podonoghue/usbdm-kinetis/README.md

# usbdm-kinetis

USBDM BDM based on Kinetis device

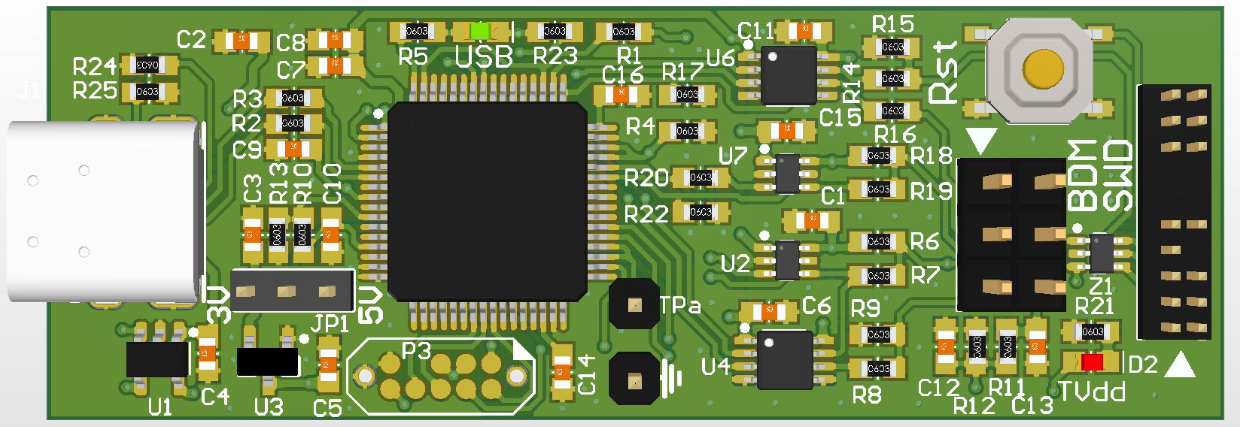
[picture p1: Hardware/USBDM_Kinetis_MK22F/USBDM_Kinetis_MK22F.png]
An image Board Image
