podonoghue/usbdm-kinetis/Hardware/README.md

# USBDM Kinetis (PCB Designs)  
PCB designs for Kinetis based USBDM.  
These are Altium designer projects.  

# USBDM_Kinetis_MK22F_V3.3 (MK22F Version)  
Supports initial bootloader, higher speed communication.  
Refer to the PDFs in the Project Outputs directory 
<a href="https://raw.githubusercontent.com/podonoghue/usbdm-kinetis/master/Hardware/USBDM_Kinetis_MK22F/USBDM_Kinetis_MK22F.PDF">PDF Documentation</img></a>

An image Board Image
