podonoghue/usbdm-kinetis/Firmware/ReadMe.md

# usbdm-kinetis

USBDM BDM based on Kinetis device

This is the firmware for the BDM.  
It required Eclipse with USBDM plugins and ARM toolchain.
