podonoghue/usbdm-kinetis/Hardware/USBDM_Kinetis_MK22F/USBDM_Kinetis.PcbDoc.htm

Reporting Options

# File in Previous Format

Date | : | 11-Jan-22
Time | : | 10:05:31 PM
Filename | : | Z:\Documents\Development\usbdm-kinetis\Hardware\USBDM_Kinetis_MK22F\USBDM_Kinetis.PcbDoc

Version | Warning

This file was generated by an earlier version of the software
