podonoghue/usbdm-kinetis/Hardware/Id.xlsx

 |  | Ratio | R1 | R2 | Ratio | R1 | R2 | R1 | R2
 | 0 | 0.00 | 10 | 0.00 | 0.00 | 10.00 | 0.00 | 10K | 0R | 0.00 | 10K/0R | 0.0 | 17.08
 | 0.06666666667 | 0.07 | 10 | 0.71 | 0.07 | 10.00 | 0.71 | 10K | 715R | 17.08 | 10K/715R | 1.0 | 17.08
 | 0.1333333333 | 0.13 | 10 | 1.54 | 0.13 | 10.00 | 1.54 | 10K | 1.54K | 34.16 | 10K/1.54K | 2.0 | 16.87
 | 0.2 | 0.20 | 10 | 2.50 | 0.20 | 10.00 | 2.49 | 10K | 2.49K | 51.04 | 10K/2.49K | 3.0 | 17.42
 | 0.2666666667 | 0.27 | 10 | 3.64 | 0.27 | 10.00 | 3.65 | 10K | 3.65K | 68.45 | 10K/3.65K | 4.0 | 16.77
 | 0.3333333333 | 0.33 | 10 | 5.00 | 0.33 | 10.00 | 4.99 | 10K | 4.99K | 85.22 | 10K/4.99K | 5.0 | 17.03
 | 0.4 | 0.40 | 10 | 6.67 | 0.40 | 10.00 | 6.65 | 10K | 6.65K | 102.25 | 10K/6.65K | 6.0 | 16.56
0 | 0.4666666667 | 0.47 | 10 | 8.75 | 0.46 | 10.00 | 8.66 | 10K | 8.66K | 118.81 | 10K/8.66K | 7.0 | 18.38
0.6666666667 | 0.5333333333 | 0.53 | 8.75 | 10.00 | 0.54 | 8.66 | 10.00 | 8.66K | 10K | 137.19 | 8.66K/10K | 8.0 | 16.56
1.428571429 | 0.6 | 0.60 | 6.67 | 10.00 | 0.60 | 6.65 | 10.00 | 6.65K | 10K | 153.75 | 6.65K/10K | 9.0 | 17.03
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
