podonoghue/usbdm-kinetis/Hardware/USBDM_Kinetis_MK22F/USBDM_Kinetis_MK22F_V3_2.png

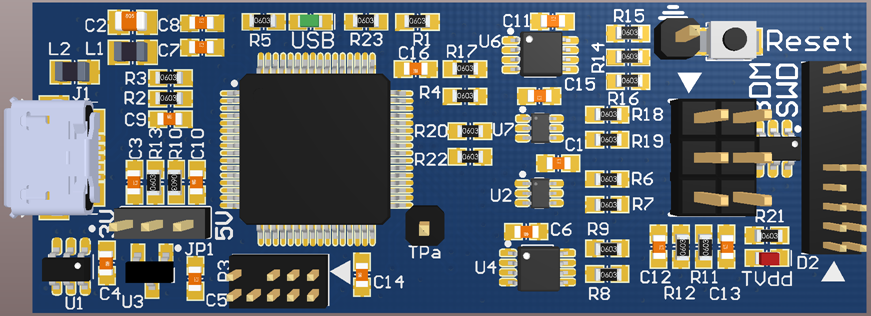
Hardware/USBDM_Kinetis_MK22F/USBDM_Kinetis_MK22F_V3_2.png
