podonoghue/usbdm-kinetis/Hardware/USBDM_Kinetis_MK22F/USBDM_Kinetis_MK22F.PDF

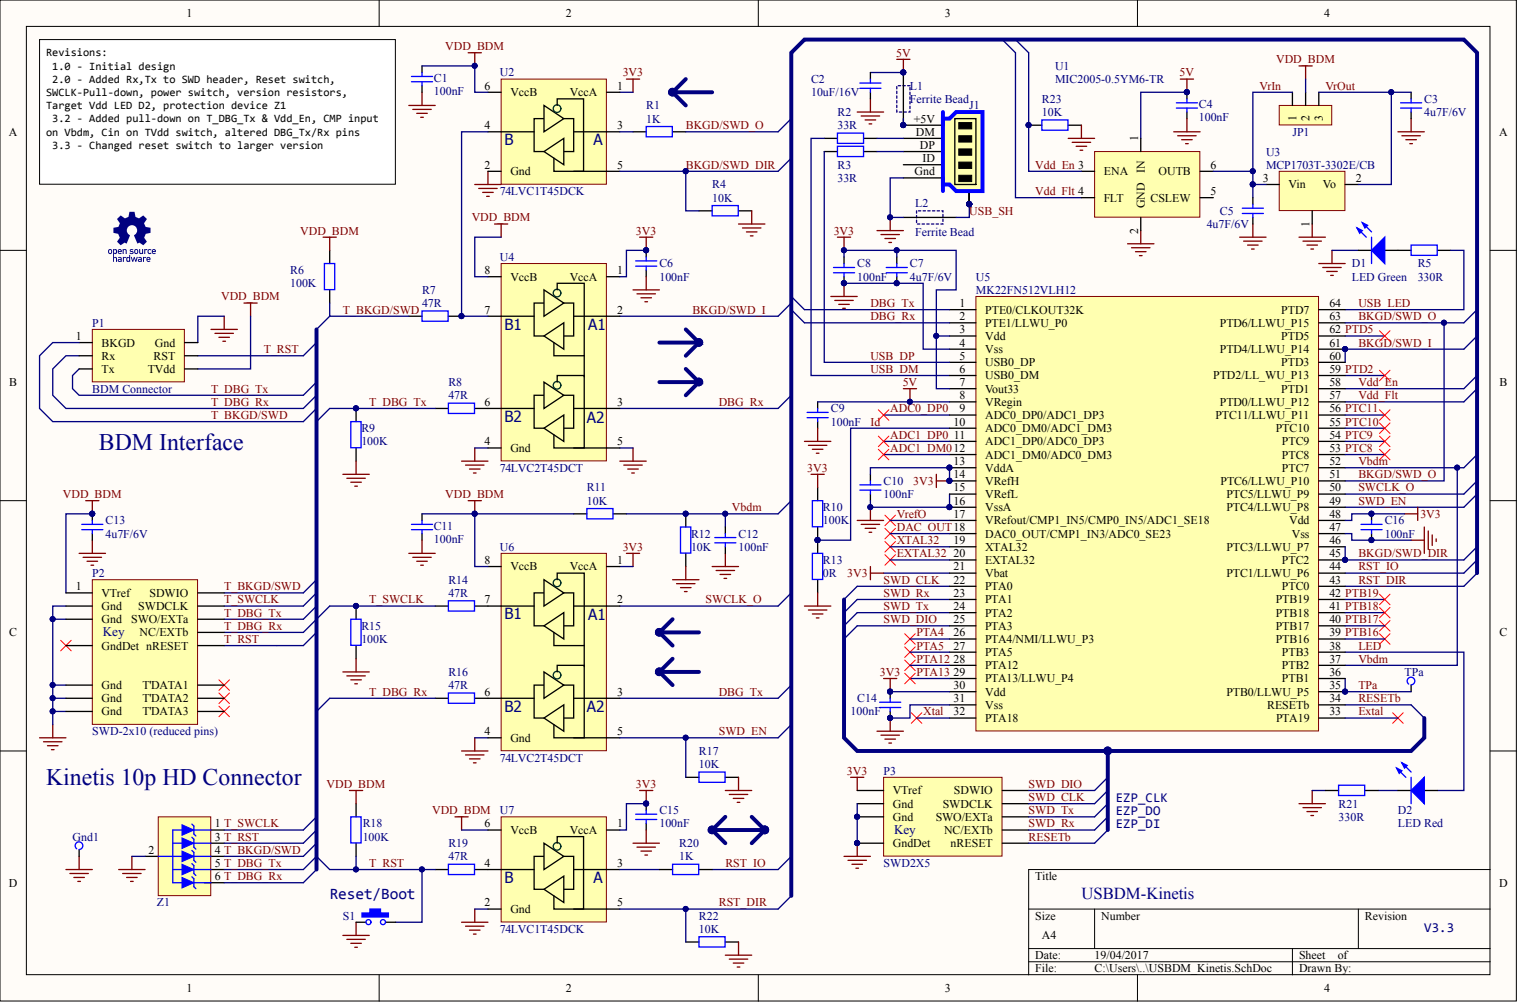
[picture p3: page 1]

Revisions:
1.0 - Initial design
2.0 - Added Rx,Tx to SWD header, Reset switch,
SWCLK-Pull-down, power switch, version resistors,
Target Vdd LED D2, protection device Z1
3.2 - Added pull-down on T_DBG_Tx & Vdd_En, CMP input
on Vbdm, Cin on TVdd switch, altered DBG_Tx/Rx pins
3.3 - Changed reset switch to larger version

PTD5 BKGD/SWD_I

100nF | VssA 16 | SWD_EN
VrefO | VRefout/CMP1_IN5/CMP0_IN5/ADC1_SE18 17

VRefL 15 | SWCLK_O

EXTAL32 20 | BKGD/SWD_DIR
Vbat 21 | RST_IO
PTA0 22 | RST_DIR

Vdd 30 | TPa
Vss 31 | RESETb
Xtal | | Extal

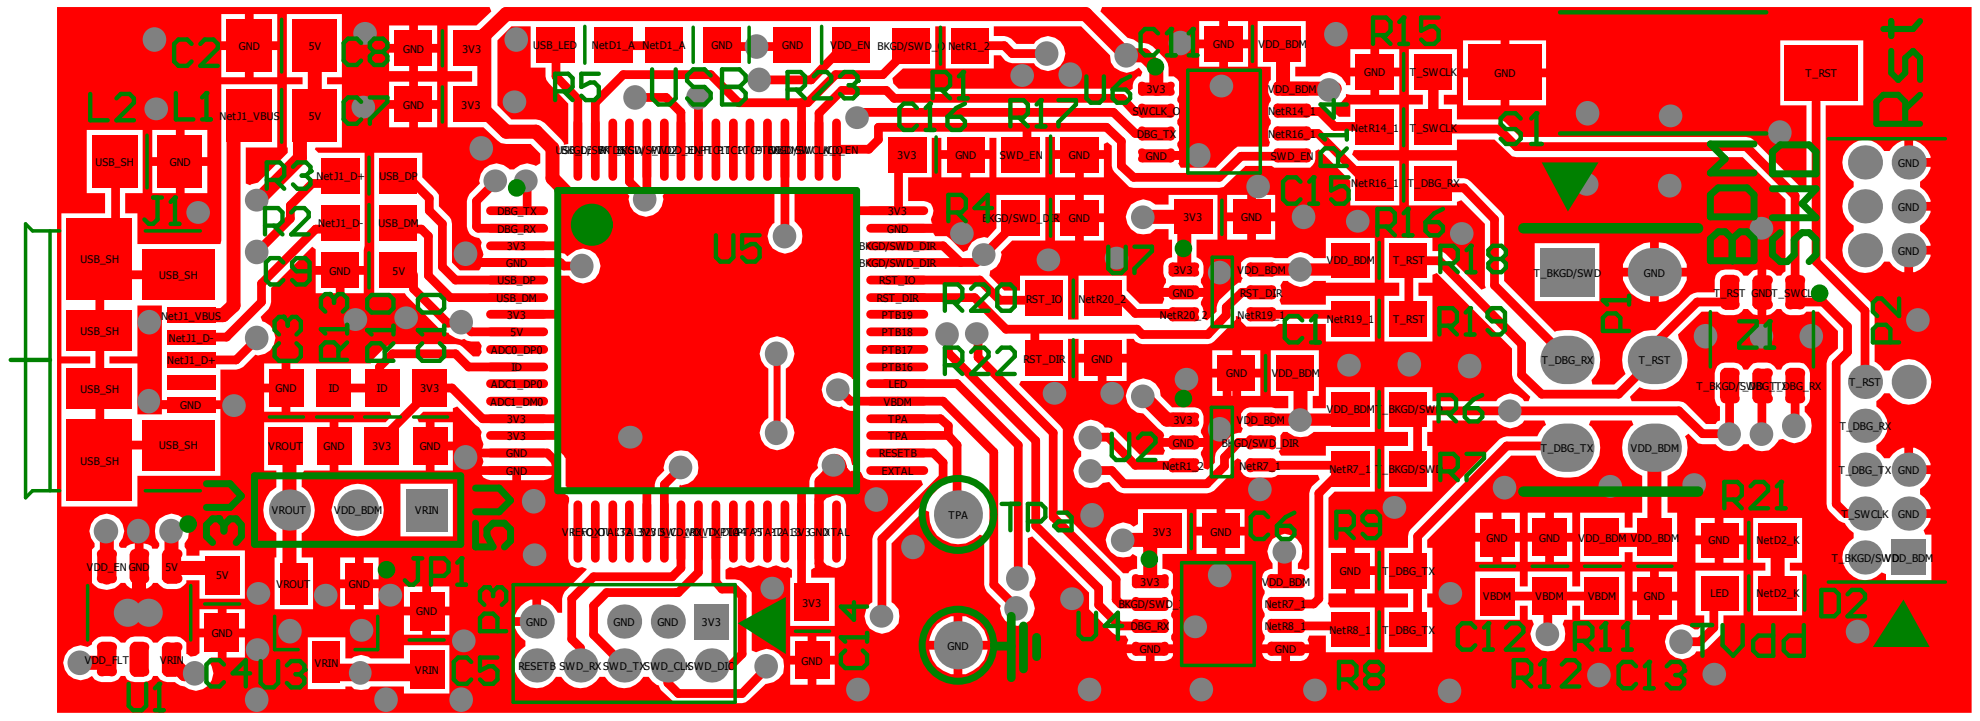
[picture p4: page 2]

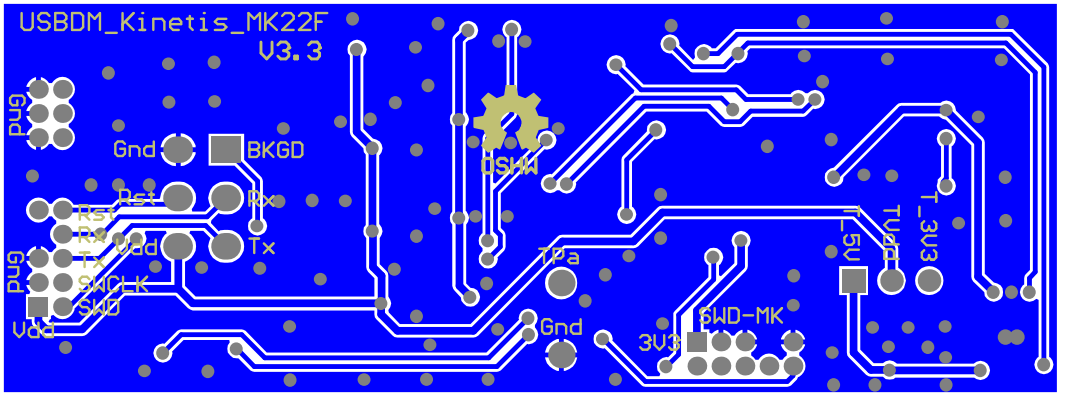
[picture p5: page 3]

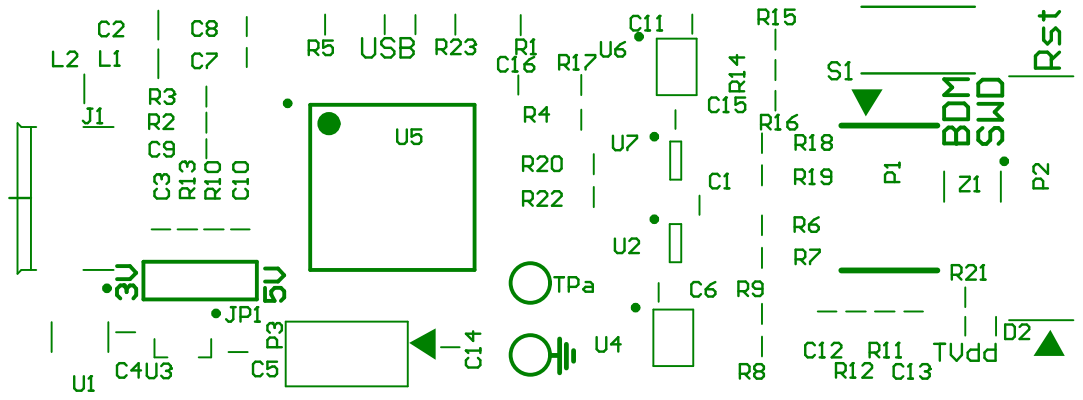
[picture p6: page 4]

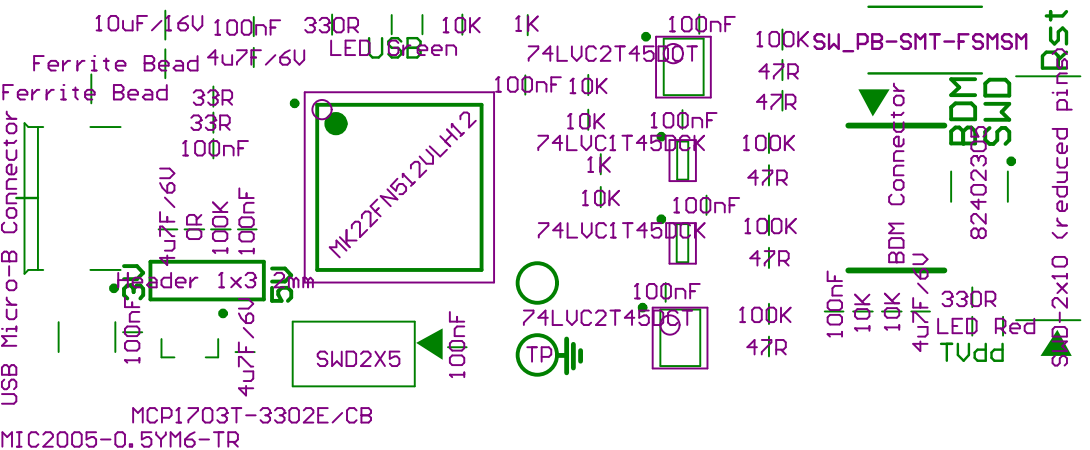
[picture p7: page 5]

Bill of Materials | Bill of Materials For Project [USBDM_Kinetis_MK22F.PrjPcb] (No PCB Document Selected)
Source Data From: | USBDM_Kinetis_MK22F.PrjPcb
Project: | USBDM_Kinetis_MK22F.PrjPcb
Variant: | None
Creation Date: | 19/04/2017 | 12:34:40 PM
Print Date: | 19-Apr-17 | 12:34:47 PM
Footprint | Comment | Farnell PN | Digikey | Designator | Description | Quantity
CCNP1608-0603 | 100nF | 1709957 | | C1, C4, C6, C8, C9, C10, C11, C12, C14, C15, C16 | Capacitor SMT 0603 | 11
CCNP2012-0805 | 10uF/16V | 2497049 | | C2 | Capacitor SMT 0805 | 1
CCNP1608-0603 | 4u7F/6V | 2496930 | | C3, C5, C7, C13 | Capacitor SMT 0603 | 4
LED1608-0603-GREEN | LED Green | 1581242 | | D1 | LED 0603 Green (HSMG-C170 1.25mm x 1.4mm, 20 mA, 2.2 V, 572 nm) | 1
LED1608-0603-RED | LED Red | 5790839 | | D2 | LED 0603 Red (HSMS-C170, 1.25mm x 1.4mm, 20 mA, 2.1 V, 626 nm) | 1
MOLEX - 47346-0001 | USB Micro-B Connector | 1568026 | | J1 | USB Micro-B (MOLEX - 47346-0001) | 1
Header 1x3 (2mm) | Header 1x3 2mm | | | JP1 | Header, 1x3, 2mm | 1
FB2012-0805 | Ferrite Bead | 1669733 | | L1, L2 | Ferrite Bead SMT 0805, TDK MPZ2012S102AT, 0.15OHM, 1.5A | 2
BDM | BDM Connector | | | P1 | HCS BDM connector (2x3 0.1") | 1
SWD-2x10 - reduced | SWD-2x10 (reduced pins) | 1865289 | | P2 | SWD Connector 2x10-Pin (reduced pins) | 1
SWD-2x5 | SWD2X5 | 1865285 | | P3 | SWD Connector 2x5-Pin | 1
CR1608-0603 | 1K | 2331727 | | R1, R20 | Resistor SMT 0603 | 2
CR1608-0603 | 33R | 1632431 | | R2, R3 | Resistor SMT 0603 | 2
CR1608-0603 | 10K | 1799366 | | R4, R11, R12, R17, R22, R23 | Resistor SMT 0603 | 6
CR1608-0603 | 330R | 2502447 | | R5, R21 | Resistor SMT 0603 | 2
CR1608-0603 | 100K | 9238727 | | R6, R9, R10, R15, R18 | Resistor SMT 0603 | 5
CR1608-0603 | 47R | 1646283 | | R7, R8, R14, R16, R19 | Resistor SMT 0603 | 5
CR1608-0603 | 0R | 2668260 | | R13 | Resistor SMT 0603 | 1
SW_MIN_PB-FSMSM | SW_PB-SMT-FSMSM | 1703878 | 450-1758-2-ND | S1 | SWITCH, TACTILE SPST 50mA, SMD GULL WING | 1
SOT23-6-Power | MIC2005-0.5YM6-TR | 2509880 | | U1 | Power Switch | 1
SC70_N | 74LVC1T45DCK | 2395603 | | U2, U7 | Dual voltage bidirection buffer | 2
SOT23 | MCP1703T-3302E/CB | 2136813 | | U3 | 3V3 LDO regulator | 1 2 1 1
SSOP8_N | 74LVC2T45DCT | 2444915 | | U4, U6 | Dual voltage bidirection buffer
TSQFP50P1200X1200-64L | MK22FN512VLH12 | 2434224 | | U5 | Arm Cortex M4F
SOT23-6 | 82402305 | 1825866 | | Z1 | Quintuple Unipolar Protection Device (5V)
| | | | | | 57
Approved | | Notes
