podonoghue/usbdm-kinetis/Hardware/USBDM_Kinetis_MK22F/USBDM_Kinetis_MK22F - Assembly.PDF

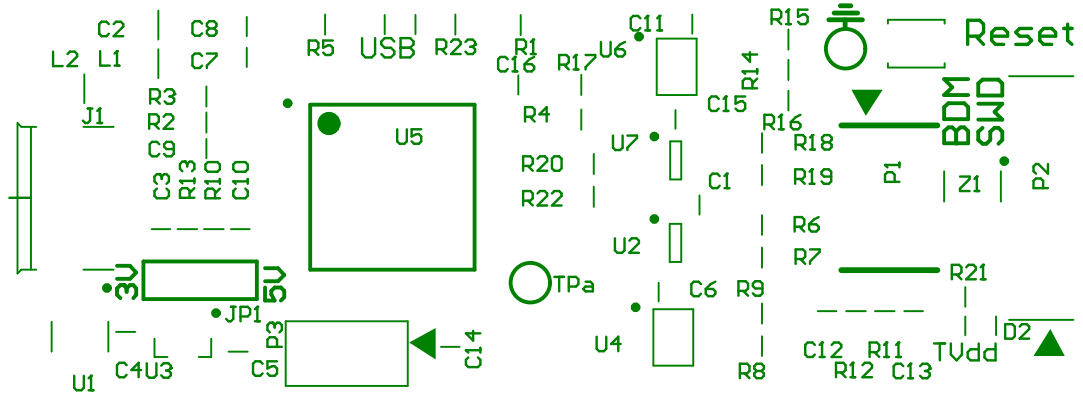
[picture p8: page 1]

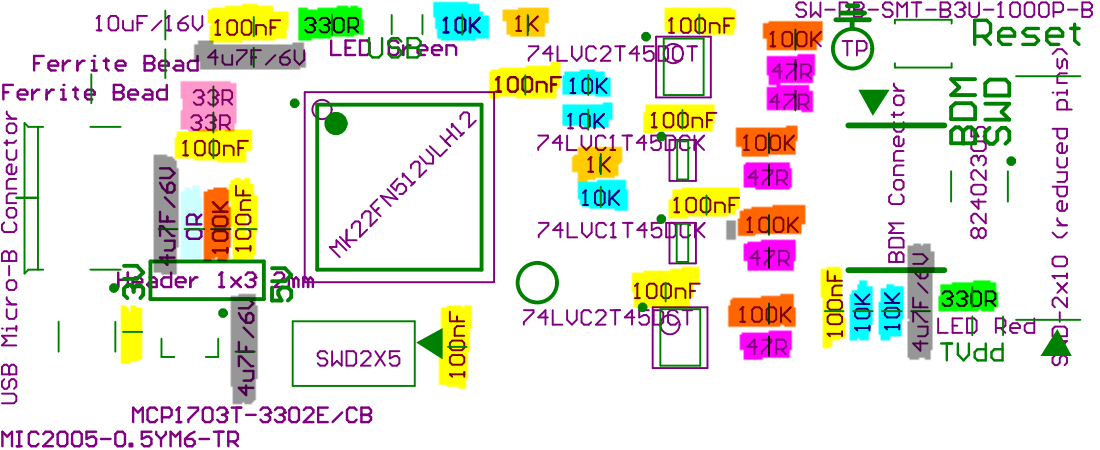
[picture p9: page 2]
