podonoghue/usbdm-kinetis/(list of files, drawings)

Other design files:
Hardware/USBDM_Kinetis_MK22F/USBDM_Kinetis-CS.PcbDoc
Hardware/USBDM_Kinetis_MK22F/USBDM_Kinetis.PcbDoc
Hardware/USBDM_Kinetis_MK22F/USBDM_Kinetis.SchDoc
Hardware/USBDM_Kinetis_MK22F/USBDM_Kinetis_MK22F.PrjPcb
