podonoghue/usbdm-kinetis/Firmware/bdm_kinetis_mk22f/Sources/cmdProcessingHCS.cpp

/*! \file
    \brief USBDM - common HCS12, HCS08, RS08 & Coldfire V1 BDM commands.

    This file processes the commands received over the USB link from the host

   \verbatim
   This software was modified from \e TBLCF software
   This software was modified from \e TBDML software

   USBDM
   Copyright (C) 2007  Peter O'Donoghue

   Turbo BDM Light
   Copyright (C) 2005  Daniel Malik

   Turbo BDM Light ColdFire
   Copyright (C) 2005  Daniel Malik

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
   You should have received a copy of the GNU General Public License
   along with this program; if not, write to the Free Software
   Foundation, Inc., 59 Temple Place, Suite 330, Boston, MA  02111-1307  USA
   \endverbatim

   \verbatim
   Change History
   +============================================================================================
   | 3  Dec 2016 | Ported to Kinetis                                                - V4.121.160
   +============================================================================================
   \endverbatim
 */
#include <interfaceCommon.h>
#include <string.h>
#include "utilities.h"
#include "configure.h"
#include "commands.h"
#include "bdm.h"
#include "bdmMacros.h"
#include "cmdProcessing.h"
#include "cmdProcessingHCS.h"
#include "targetDefines.h"

namespace Cfv1 {

using namespace Bdm;

/**
 *  CFV1 -  Used to reset the CFV1 target interface from overrun condition
 *
 *  @return == BDM_RC_OK => success
 *  @return != BDM_RC_OK => error
 */
static USBDM_ErrorCode resetCFV1Interface(void) {
   uint8_t status;
   uint8_t attempt;
   USBDM_ErrorCode rc;

   for (attempt=0; attempt < 3; attempt++) {
      /*
       * Try CFV1 recovery process
       */
      // Reset BDM interface & reconnect
      rc = connect();
      if (rc != BDM_RC_OK) {
         return rc;
      }
      switch(attempt) {
         case 0:
            break;
         case 1: // Issue background command and try again
            BDMCF_CMD_BACKGROUND();
            break;
         case 2: // Reset target and try again
            softwareReset(RESET_SPECIAL);
            break;
      }
      // Issue NOP
      rc = BDMCF_CMD_NOP();
      if (rc != BDM_RC_OK) {
         continue;
      }
      // Re-read status
      rc = readBDMStatus(&status);
      if (rc != BDM_RC_OK) {
         continue;
      }
      // Interface should now be IDLE
      if ((status & CFV1_XCSR_CSTAT) == CFV1_XCSR_CSTAT_OK)
         return BDM_RC_OK;
   }
   return rc;
}
}; // End namespace Cfv1

namespace Hcs {

using namespace Bdm;

/**
 *  HCS12/HCS08/RS08/CFV1 - Try to connect to the target
 *
 *  @return == BDM_RC_OK => success
 *  @return != BDM_RC_OK => error
 */
USBDM_ErrorCode f_CMD_CONNECT(void) {
   USBDM_ErrorCode rc;

   rc = connect();
   if ((rc == BDM_RC_OK) && (bdm_option.useAltBDMClock != CS_DEFAULT)) {
      uint8_t bdm_sts;

      // Re-write Status/control register since Force BDM clock is active
      rc = readBDMStatus(&bdm_sts);
      if (rc != BDM_RC_OK) {
         return rc;
      }
      if (cable_status.target_type == T_CFV1) {
         // Make sure we don't accidently erase the chip!
         bdm_sts &= ~(CFV1_XCSR_SEC);
      }
      rc = writeBDMControl(bdm_sts);
      if (rc != BDM_RC_OK) {
         return rc;
      }
      // Re-connect in case speed changed from above
      rc = connect();
   }
   return rc;
}

/**
 *  HCS12/HCS08/RS08/CFV1 -  Set communication speed to user supplied value
 *
 *  @note
 *   commandBuffer                                 \n
 *   - [2..3] = 16-bit Sync value in 60MHz ticks
 *
 *  @return == BDM_RC_OK => success
 *  @return != BDM_RC_OK => error
 */
USBDM_ErrorCode f_CMD_SET_SPEED(void) {
   // Get speed
   uint16_t syncValue = (pack16BE(commandBuffer+2)*4)/5;

   if (syncValue == 0) {
      // Set to unknown (re-enable auto detection etc.)
      cable_status.speed = SPEED_NO_INFO;
      // Try to connect
      return f_CMD_CONNECT();
   }

   // Conversion from timer ticks to standard HCS12 sync value.
   setSyncLength(syncValue/2);

   // User told us (even if it doesn't work!)
   cable_status.speed = SPEED_USER_SUPPLIED;

   if (cable_status.target_type == T_HC12) {
      // Confirm operation at that speed
      USBDM_ErrorCode rc = Hcs::hc12confirmSpeed(syncValue);
      if (rc != BDM_RC_OK) {
         // Failed
         return rc;
      }
   }
   // Try ACKN feature
   enableACKNMode();

   // Try to enable BDM
   return enableBDM();
}

/**
 *  HCS12,HCS08,RS08 & CFV1 -  Read current speed
 *
 *  @note commandBuffer                             \n
 *    - [1..2] => 16-bit Sync value in 60MHz ticks
 *
 *  @return == BDM_RC_OK => success
 *  @return != BDM_RC_OK => error
 */
USBDM_ErrorCode f_CMD_GET_SPEED(void) {
   // ToDo - Consider conversion from timer ticks to standard HCS12 sync value. On this processor they are equal
   unpack16BE(cable_status.sync_length, commandBuffer+1);
   returnSize = 3;
   return BDM_RC_OK;
}

/**
 *  HCS12/HCS08/RS08/CFV1 -  Read Target BDM Status Register
 *
 *  @note commandBuffer \n
 *   - [1..4] => 8-bit Status register [MSBs are zero]
 *
 *  @return == BDM_RC_OK => success
 *  @return != BDM_RC_OK => error
 */
USBDM_ErrorCode f_CMD_READ_STATUS_REG(void) {
   USBDM_ErrorCode rc;
   returnSize = 5;
   commandBuffer[1] = 0;
   commandBuffer[2] = 0;
   commandBuffer[3] = 0;

   rc = optionalReconnect(AUTOCONNECT_STATUS);
   if (rc != BDM_RC_OK) {
      return rc;
   }
   rc = readBDMStatus(commandBuffer+4);
   if (rc != BDM_RC_OK) {
      return rc;
   }
   if ((cable_status.target_type == T_CFV1) &&
         ((commandBuffer[4] & CFV1_XCSR_CSTAT) == CFV1_XCSR_CSTAT_OVERRUN)) {
      // Try CFV1 recovery process
      rc = Cfv1::resetCFV1Interface();
      if (rc != BDM_RC_OK) {
         return rc;
      }
      rc = readBDMStatus(commandBuffer+4);
   }
   return rc;
}

/**
 *  HCS12/HCS08/RS08/CFV1 -  Write Target BDM Control Register
 *
 *  @note
 *   commandBuffer                                          \n
 *    - [2..5] => 8-bit control register value [MSBs ignored]
 *
 *  @return == BDM_RC_OK => success
 *  @return != BDM_RC_OK => error
 */
USBDM_ErrorCode f_CMD_WRITE_CONTROL_REG(void) {
   return writeBDMControl(commandBuffer[5]);
}

/**
 *  HCS12/HCS08/RS08/CFV1 -  Reset Target
 *
 *  @note
 *   commandBuffer                                          \n
 *    - [2] => 8-bit reset control [see \ref TargetMode_t]
 *
 *  @return == BDM_RC_OK => success
 *  @return != BDM_RC_OK => error
 */
USBDM_ErrorCode f_CMD_RESET(void) {

   TargetMode_t    mode = (TargetMode_t)(commandBuffer[2]&RESET_MODE_MASK);
   USBDM_ErrorCode rc   = BDM_RC_OK;

   // TODO This may take a while
   //setBDMBusy();

   rc = optionalReconnect(AUTOCONNECT_STATUS);
   if (rc != BDM_RC_OK) {
      return rc;
   }
   cable_status.bdmpprValue = 0x00;

   switch (commandBuffer[2] & RESET_METHOD_MASK) {
#if (HW_CAPABILITY&CAP_RST_IO)
      case RESET_HARDWARE :
         rc = hardwareReset(mode);
         break;
#endif
      case RESET_SOFTWARE :
         rc = softwareReset(mode);
         break;
#if (HW_CAPABILITY&CAP_VDDCONTROL)
      case RESET_POWER :
         rc = cycleTargetVdd(mode);
         break;
#endif
      case RESET_ALL :
      default:
         rc = targetReset(mode);
   }
   if (cable_status.speed != SPEED_USER_SUPPLIED) {
      // Assume we have lost connection after reset attempt
      cable_status.speed  = SPEED_NO_INFO;
   }
   // BDM resetting the target doesn't count as a reset!
//   cable_status.reset  = NO_RESET_ACTIVITY;
   // ACKN feature is disabled after reset
   cable_status.ackn   = WAIT;

#if 0
   if (rc != BDM_RC_OK) {
      return rc;
   }
   // User specified speed?
   if (cable_status.speed == SPEED_USER_SUPPLIED) {
      // Confirm we can still operate at that speed
      (void)bdmHC12_confirmSpeed(cable_status.sync_length);
      // ToDo - check what should be done with rc
      (void)bdm_enableBDM(); //  & enable BDM mode
   }
   else if ((bdm_option.autoReconnect) || (cable_status.speed == SPEED_SYNC))
      // Re-connect if Auto re-connect enabled or it's quick to do (ACKN was found previously)
      // Done even if no SYNC feature - may be slow!
      (void)bdm_connect();
   else {
      // Indicate we no longer have a connection
      cable_status.speed  = SPEED_NO_INFO;
   }
#endif

   return rc;
}

/**
 *  HCS12/HCS08/RS08/CFV1 -  Step over 1 instruction
 *
 *  @return == BDM_RC_OK => success
 *  @return != BDM_RC_OK => error
 */
USBDM_ErrorCode f_CMD_STEP(void) {
   return step();
}

/**
 *  HCS12/HCS08/RS08/CFV1 -  Start code execution
 *
 *  @return == BDM_RC_OK => success
 *  @return != BDM_RC_OK => error
 */
USBDM_ErrorCode f_CMD_GO(void) {
   return go();
}

/**
 *  HCS12/HCS08/RS08/CFV1 -  Stop the target
 *
 *  @return == BDM_RC_OK => success
 *  @return != BDM_RC_OK => error
 */
USBDM_ErrorCode f_CMD_HALT(void) {
   return halt();
}
}; // end namespace HCS

namespace Hcs12 {

using namespace Hcs;

/**
 *  HCS12 Write debug register/memory map
 *
 *  @note
 *   commandBuffer                                       \n
 *   - [2..3] => 16-bit register number [MSB ignored]    \n
 *   - [4..7] => 32-bit register value  [MSBs ignored]
 *
 *  @return == BDM_RC_OK => success
 *  @return != BDM_RC_OK => error
 */
USBDM_ErrorCode f_CMD_WRITE_BD(void) {
   uint16_t addr = pack16BE(commandBuffer+2);
   if (addr == HC12_BDMSTS) {
      // Access to BDMSTS is mapped to write control
      return writeBDMControl(commandBuffer[7]);
   }
   return BDM12_CMD_BDWRITEB(addr,commandBuffer[7]);
}

/**
 *  HCS12 Read debug register/memory map
 *
 *  @note
 *   commandBuffer                                    \n
 *   - [2..3] => 16-bit register number [MSB ignored] \n
 *                                                    \n
 *   commandBuffer                                    \n
 *   - [1..4] => 32-bit register value  [MSBs zeroed]
 *
 *  @return == BDM_RC_OK => success
 *  @return != BDM_RC_OK => error
 */
USBDM_ErrorCode f_CMD_READ_BD(void) {
   uint16_t addr = pack16BE(commandBuffer+2);

   // If reading HCS12 status use f_CMD_READ_STATUS_REG()
   if (addr == HC12_BDMSTS) {
      return f_CMD_READ_STATUS_REG();
   }
   commandBuffer[1] = 0;
   commandBuffer[2] = 0;
   commandBuffer[3] = 0;
   returnSize = 5;
   return BDM12_CMD_BDREADB(addr,commandBuffer+4);
}

#if 0
#pragma MESSAGE DISABLE C4001 // Disable warnings about condition always true
/**
 *  HCS12/RS08/HCS08  Read all registers
 *
 *  @note commandBuffer        \n
 *   - [1..] => ?-bit value
 *
 *  @return == BDM_RC_OK => success
 *  @return != BDM_RC_OK => error
 */
USBDM_ErrorCode f_CMD_READ_REGS(void) {
   switch (cable_status.target_type) {
      case T_HC12:
         BDM12_CMD_READ_PC(commandBuffer+1);
         BDM12_CMD_READ_SP(commandBuffer+3);
         BDM12_CMD_READ_X(commandBuffer+5);
         BDM12_CMD_READ_Y(commandBuffer+7);
         BDM12_CMD_READ_D(commandBuffer+9);
         BDM12_CMD_BDREADW(HC12_BDMCCR,commandBuffer+12);
         returnSize = 13;
         return BDM_RC_OK;
      case T_HCS08:
         BDM08_CMD_READ_PC(commandBuffer+1);
         BDM08_CMD_READ_SP(commandBuffer+3);
         BDM08_CMD_READ_HX(commandBuffer+5);
         BDM08_CMD_READ_A(commandBuffer+7);
         BDM08_CMD_READ_CCR(commandBuffer+9);
         returnSize = 9;
         return BDM_RC_OK;
      case T_RS08:
         BDM08_CMD_READ_PC(commandBuffer+1);    // RS08 Read CCR+PC
         BDM08_CMD_READ_SP(commandBuffer+3);    // RS08 Read Shadow PC
         commandBuffer[5] = 0;                  // RS08 Doesn't have Read HX
         commandBuffer[6] = 0;
         BDM08_CMD_READ_A(commandBuffer+7);     // RS08 Read A
         commandBuffer[8] = 0;                  // RS08 Doesn't have Read CCR
         returnSize = 9;
         return BDM_RC_OK;
   }
   return BDM_RC_ILLEGAL_COMMAND;
}
#pragma MESSAGE DEFAULT C4001 // Restore warnings about condition always true
#endif

//======================================================================
//======================================================================
//======================================================================

/**
 *  HCS12 -  set BDMPPR register
 *
 *  @param memorySpace - Used to determine if using Global address
 *  @param addr23To16  - Global Page number address[23:16]
 *
 *  @return == BDM_RC_OK => success
 *  @return != BDM_RC_OK => error
 */
USBDM_ErrorCode setBdmppr(uint8_t memorySpace, uint8_t addr23To16) {
   USBDM_ErrorCode rc = BDM_RC_OK;

   if ((memorySpace&MS_SPACE) == MS_Global) {
      // Using Global address - set BDMPPR
      cable_status.bdmpprValue = HC12_BDMPPR_BPAE|addr23To16;
      rc = BDM12_CMD_BDWRITEB(HC12_BDMPPR, HC12_BDMPPR_BPAE|addr23To16);
   }
   else {
      // Not using Global address - Clear BDMPPR if set
      if (cable_status.bdmpprValue != 0) {
         cable_status.bdmpprValue = 0;
         rc = BDM12_CMD_BDWRITEB(HC12_BDMPPR, 0x00);
      }
   }
   return rc;
}

#if 1
/**
 *  HCS12 -  Write block of bytes to memory
 *
 *  @note
 *   commandBuffer                                   \n
 *   - [2]    = element size [ignored]/memory space  \n
 *   - [3]    = # of bytes                           \n
 *   - [4..7] = address [MSB ignored]                \n
 *   - [8..N] = data to write
 *
 *  @return == BDM_RC_OK => success
 *  @return != BDM_RC_OK => error
 */
USBDM_ErrorCode f_CMD_WRITE_MEM(void) {
   uint8_t  count       = commandBuffer[3];
   uint16_t addr        = pack16BE(commandBuffer+6);
   uint8_t  *data_ptr   = commandBuffer+8;
   USBDM_ErrorCode  rc  = BDM_RC_OK;

   // Element size & address[23:16]
   rc = setBdmppr(commandBuffer[2], commandBuffer[5]);
   if (rc != BDM_RC_OK) {
      return rc;
   }
   if (addr&0x0001) {
      // Address is odd
      rc = BDM12_CMD_WRITEB(addr,*data_ptr); // write byte
      addr     +=1;  // increment memory address
      data_ptr +=1;  // increment buffer pointer
      count    -=1;  // decrement count of bytes
   }
   if (commandBuffer[2]&MS_Fast) {
      // Fast word writes - modifies X
      // Write address to X
      rc = BDM12_CMD_WRITE_X(addr-2);
      // Exclude 0xFF00-0xFFFF as BDM code in Memory map
      while ((count > 1) && (rc == BDM_RC_OK) && ((addr&0xFF00) != 0xFF00)) {
         rc = BDM12_CMD_WRITE_NEXT(pack16BE(data_ptr)); // write word
         addr     +=2; // increment memory address
         data_ptr +=2; // increment buffer pointer
         count    -=2; // decrement count of bytes
      }
   }
   while ((count > 1) && (rc == BDM_RC_OK)) {
      // Slow Word writes
//      USBDM::console.write("cmd_2W_0").write(addr).writeln(*(uint16_t *)data_ptr);

      rc = BDM12_CMD_WRITEW(addr,pack16BE(data_ptr));  // write a word
      addr     +=2; // increment memory address
      data_ptr +=2; // increment buffer pointer
      count    -=2; // decrement count of bytes
   }
   if (count > 0) {
      // Odd last byte
      rc = BDM12_CMD_WRITEB(addr,*data_ptr);  // fetch a byte
   }
   return rc;
}
#else
/**
 *  HCS12 -  Write block of bytes to memory
 *
 *  @note
 *   commandBuffer                                   \n
 *   - [2]    = element size [ignored]/memory space  \n
 *   - [3]    = # of bytes                           \n
 *   - [4..7] = address [MSB ignored]                \n
 *   - [8..N] = data to write
 *
 *  @return == BDM_RC_OK => success
 *  @return != BDM_RC_OK => error
 */
USBDM_ErrorCode f_CMD_WRITE_MEM(void) {
   uint8_t  count       = commandBuffer[3];
   uint16_t addr        = pack16BE(commandBuffer+6);
   uint8_t  *data_ptr   = commandBuffer+8;
   uint8_t  rc          = BDM_RC_OK;

   rc = setBdmppr(commandBuffer[2], commandBuffer[5]); // element size & address[23:16]
   if (rc != BDM_RC_OK) {
      return rc;
   }
   while ((count > 0) && (rc == BDM_RC_OK)) {
      if ((addr&0x0001) || (count == 1)) {
         // Address is odd or only 1 byte remaining
         rc = BDM12_CMD_WRITEB((uint16_t)addr,*data_ptr);// write byte
         addr     +=1;                    // increment memory address
         data_ptr +=1;                    // increment buffer pointer
         count    -=1;                    // decrement count of bytes
      }
      else {
         // Even address && >=2 bytes remaining
         rc = BDM12_CMD_WRITEW((uint16_t)addr,pack16BE(data_ptr)); // write a word
         addr     +=2;                    // increment memory address
         data_ptr +=2;                    // increment buffer pointer
         count    -=2;                    // decrement count of bytes
      }
   }
   return rc;
}
#endif

#if 1
/**
 *  HCS12 -  Read block of data from memory
 *
 *  @note
 *   commandBuffer                                   \n
 *   - [2]    = element size [ignored]/memory space  \n
 *   - [3]    = # of bytes                           \n
 *   - [4..7] = address [MSB ignored]                \n
 *                                                   \n
 *   commandBuffer                                   \n
 *   - [1..N] = data read
 *
 *  @return == BDM_RC_OK => success
 *  @return != BDM_RC_OK => error
 */
USBDM_ErrorCode f_CMD_READ_MEM(void) {
   uint8_t  count       = commandBuffer[3];
   uint16_t addr        = pack16BE(commandBuffer+6);
   uint8_t  *data_ptr   = commandBuffer+1;
   USBDM_ErrorCode  rc = BDM_RC_OK;

   if (count>MAX_COMMAND_SIZE-1) {
      return BDM_RC_ILLEGAL_PARAMS;  // requested block+status is too long to fit into the buffer
   }
   rc = setBdmppr(commandBuffer[2], commandBuffer[5]); // element size & address[23:16]
   if (rc != BDM_RC_OK) {
      return rc;
   }
   returnSize = count+1;
   if (addr&0x0001) {
      // Odd first byte
      rc = BDM12_CMD_READB((uint16_t)addr,data_ptr);  // fetch a byte
      addr     +=1; // increment memory address
      data_ptr +=1; // increment buffer pointer
      count    -=1; // decrement count of bytes
   }
   if (commandBuffer[2]&MS_Fast) {
      // Fast word reads - corrupts X
      // Write address to X
      rc = BDM12_CMD_WRITE_X(addr-2);
      // Exclude 0xFF00-0xFFFF as BDM code in Memory map
      while ((count > 1) && (rc == BDM_RC_OK) && ((addr&0xFF00) != 0xFF00)) {
         rc = BDM12_CMD_READ_NEXT(data_ptr);
         addr     +=2; // increment memory address
         data_ptr +=2; // increment buffer pointer
         count    -=2; // decrement count of bytes
      }
   }
   while ((count > 1) && (rc == BDM_RC_OK)) {
      // Slow Word reads
      rc = BDM12_CMD_READW(addr,data_ptr);  // fetch a word
      addr     +=2; // increment memory address
      data_ptr +=2; // increment buffer pointer
      count    -=2; // decrement count of bytes
   }
   if (count > 0) {
      // Odd last byte
      rc = BDM12_CMD_READB((uint16_t)addr,data_ptr);  // fetch a byte
   }
   return rc;
}
#else
/**
 *  HCS12 -  Read block of data from memory
 *
 *  @note
 *   commandBuffer                                   \n
 *   - [2]    = element size [ignored]/memory space  \n
 *   - [3]    = # of bytes                           \n
 *   - [4..7] = address [MSB ignored]                \n
 *                                                   \n
 *   commandBuffer                                   \n
 *   - [1..N] = data read
 *
 *  @return == BDM_RC_OK => success
 *  @return != BDM_RC_OK => error
 */
USBDM_ErrorCode f_CMD_READ_MEM(void) {
   uint8_t  count       = commandBuffer[3];
   uint16_t addr        = pack16BE(commandBuffer+6);
   uint8_t  *data_ptr   = commandBuffer+1;
   uint8_t  rc          = BDM_RC_OK;

   if (count>MAX_COMMAND_SIZE-1) {
      // requested block+status is too long to fit into the buffer
      return BDM_RC_ILLEGAL_PARAMS;
   }
   // Element size & address[23:16]
   rc = setBdmppr(commandBuffer[2], commandBuffer[5]);
   if (rc != BDM_RC_OK) {
      return rc;
   }
   returnSize = count+1;
   while ((count > 0) && (rc == BDM_RC_OK)) {
      if ((addr&0x0001) || (count == 1)) {
         // Address is odd or only 1 byte remaining
         // fetch a byte
         rc = BDM12_CMD_READB((uint16_t)addr,data_ptr);
         addr     +=1; // increment memory address
         data_ptr +=1; // increment buffer pointer
         count    -=1; // decrement count of bytes
      }
      else {
         // Even address && >=2 bytes remaining
         // fetch a word
         rc = BDM12_CMD_READW((uint16_t)addr,(uint16_t*)data_ptr);
         addr     +=2; // increment memory address
         data_ptr +=2; // increment buffer pointer
         count    -=2; // decrement count of bytes
      }
   }
   return rc;
}
#endif

//======================================================================
//======================================================================
//======================================================================

/**
 *  HCS12 Write core register
 *
 *  @note
 *   commandBuffer                                          \n
 *   - [2..3] => 16-bit register number [MSB ignored]       \n
 *   - [4..7] => 32-bit register value  [some MSBs ignored]
 *
 *  @return == BDM_RC_OK => success
 *  @return != BDM_RC_OK => error
 */
USBDM_ErrorCode f_CMD_WRITE_REG(void) {
   uint16_t value = pack16BE(commandBuffer+6);
   if ((commandBuffer[3]<HCS12_RegPC) || (commandBuffer[3]>HCS12_RegSP)) {
      return BDM_RC_ILLEGAL_PARAMS;
   }
   return BDM12_CMD_WRITE_REG(commandBuffer[3], value);
}

/**
 *  HCS12 Read core register
 *
 *  @note
 *   commandBuffer                                          \n
 *   - [2..3] => 16-bit register number [MSB ignored]       \n
 *                                                          \n
 *   commandBuffer                                          \n
 *   - [1..4] => 32-bit register value  [some MSBs ignored]
 *
 *  @return == BDM_RC_OK => success
 *  @return != BDM_RC_OK => error
 */
USBDM_ErrorCode f_CMD_READ_REG(void) {
   commandBuffer[1] = 0;
   commandBuffer[2] = 0;
   returnSize = 5;

   if ((commandBuffer[3]<HCS12_RegPC) || (commandBuffer[3]>HCS12_RegSP)) {
      return BDM_RC_ILLEGAL_PARAMS;
   }
   return BDM12_CMD_READ_REG(commandBuffer[3], commandBuffer+3);
}
}; // end namespace Hcs12

namespace Hcs08 {

using namespace Hcs;

/**
 *  HCS08/RS08 -  Write block of bytes to memory
 *
 *  @note
 *   commandBuffer                           \n
 *   - [2]    = element size/mode            \n
 *   - [3]    = # of bytes                   \n
 *   - [4..7] = address [MSB ignored]        \n
 *   - [8..N] = data to write
 *
 *  @return == BDM_RC_OK => success
 *  @return != BDM_RC_OK => error
 */
USBDM_ErrorCode f_CMD_WRITE_MEM(void) {
   uint8_t         count    = commandBuffer[3];
   uint16_t        addr     = pack16BE(commandBuffer+6);
   uint8_t        *data_ptr = commandBuffer+8;
   USBDM_ErrorCode rc       = BDM_RC_OK;

   if (cable_status.speed == SPEED_NO_INFO) {
      return BDM_RC_NO_CONNECTION;
   }
   if (commandBuffer[2]&MS_Fast) {
      // Fast write - corrupts H:X
      // Write address to H:X
      rc = BDM08_CMD_WRITE_HX(addr-1);
      while ((count > 0) && (rc == BDM_RC_OK)) {
         rc = BDM08_CMD_WRITE_NEXT(*data_ptr);
         data_ptr +=1;   // increment buffer pointer
         count    -=1;   // decrement count of bytes
      }
   }
   else {
      while ((count > 0) && (rc == BDM_RC_OK)) {
#if 0
         uint8_t status;
         int retry = 20;
         // Write data & receive status
         BDM08_CMD_WRITEB_WS(addr, *data_ptr++, &status);
         while(((status&HC08_BDCSCR_DVF) != 0) && (retry-->0)) {
            // Status read may fail because of clock change!
            physicalConnect();
            // Re-read status
            BDM08_CMD_READSTATUS(&status);
         }
         if ((status&HC08_BDCSCR_DVF) != 0) {
            return BDM_RC_HCS_ACCESS_ERROR;
         }
         if ((status&HC08_BDCSCR_WSF) != 0) {
            // The only 'expected' error that should occur is because the device has entered stop or wait mode
            // Don't try to recover as this requires changing the machine state.
            return BDM_RC_TARGET_BUSY;
         }
#else
         // Write byte
         rc = BDM08_CMD_WRITEB(addr, *data_ptr++);
#endif
         // Increment memory address
         addr  +=1;
         // Decrement count of bytes remaining
         count -=1;
      }
   }
   return rc;
}
/**
 *  HCS08/RS08 -  Read block of data from memory
 *
 *  @note
 *   commandBuffer                       \n
 *   - [2]    = element size/mode        \n
 *   - [3]    = # of bytes               \n
 *   - [4..7] = address [MSB ignored]    \n
 *                                       \n
 *   commandBuffer                       \n
 *   - [1..N]  = data read
 *
 *  @return == BDM_RC_OK => success
 *  @return != BDM_RC_OK => error
 */
USBDM_ErrorCode f_CMD_READ_MEM(void) {
   uint8_t  count      = commandBuffer[3];
   uint16_t addr       = pack16BE(commandBuffer+6);
   uint8_t  *data_ptr  = commandBuffer+1;
   USBDM_ErrorCode  rc         = BDM_RC_OK;

   if (cable_status.speed == SPEED_NO_INFO) {
      return BDM_RC_NO_CONNECTION;
   }
   if (count>MAX_COMMAND_SIZE-1) {
      // Requested block+status is too long to fit into the buffer
      return BDM_RC_ILLEGAL_PARAMS;
   }
   returnSize = count+1;
   if (commandBuffer[2]&MS_Fast) {
      // Write address to H:X
      rc = BDM08_CMD_WRITE_HX(addr-1);
      while ((count > 0) && (rc == BDM_RC_OK)) {
         rc = BDM08_CMD_READ_NEXT(data_ptr);
         // Increment buffer pointer
         data_ptr +=1;
         // Decrement count of bytes
         count    -=1;
      }
   }
   else {
      while ((count > 0) && (rc == BDM_RC_OK)) {
#if 0
         uint8_t buffer[2];
         uint8_t retry = 10;
         // Read status & data byte
         BDM08_CMD_READB_WS(addr, buffer);
         while ((retry-->0) && ((buffer[0]&HC08_BDCSCR_DVF) != 0)) {
            BDM08_CMD_READ_LAST(buffer);
         }
         if ((buffer[0]&HC08_BDCSCR_DVF) != 0) {
            return BDM_RC_HCS_ACCESS_ERROR;
         }
         if ((buffer[0]&HC08_BDCSCR_WSF) != 0) {
            // The only 'expected' error that should occur is because the device has entered stop or wait mode
            // Don't try to recover as this requires changing the machine state.
            return BDM_RC_TARGET_BUSY;
         }
         // Save data
         *data_ptr++ = buffer[1];
#else
         // Read byte
         rc = BDM08_CMD_READB(addr, data_ptr++);
#endif
         // Increment memory address
         addr     +=1;
         // Decrement count of bytes
         count    -=1;
      }
   }
   return rc;
}

/**
 *  HCS08/RS08 Write core register
 *
 *  @note
 *   commandBuffer                                         \n
 *   - [2..3] => 16-bit register number [MSB ignored]      \n
 *   - [4..7] => 32-bit register value  [some MSBs ignored]
 *
 *  @return == BDM_RC_OK => success
 *  @return != BDM_RC_OK => error
 */
USBDM_ErrorCode f_CMD_WRITE_REG(void) {
   uint16_t value = pack16BE(commandBuffer+6);
   USBDM_ErrorCode rc = BDM_RC_ILLEGAL_PARAMS;

   switch (commandBuffer[3]) {
      case HCS08_RegPC :  // or RS08_RegCCR_PC :
         rc = BDM08_CMD_WRITE_PC(value);
         break;
      case HCS08_RegHX  :
         if (cable_status.target_type == T_HCS08)
            rc = BDM08_CMD_WRITE_HX(value);
         break;
      case HCS08_RegSP : // or RS08_RegSPC
         rc = BDM08_CMD_WRITE_SP(value);
         break;
      case HCS08_RegA  :  // or RS08_RegA
         rc = BDM08_CMD_WRITE_A((uint8_t)value);
         break;
      case HCS08_RegCCR  :
         if (cable_status.target_type == T_HCS08)
            rc = BDM08_CMD_WRITE_CCR((uint8_t)value);
         break;
   }
   return rc;
}

/**
 *  HCS08/RS08 Read core register
 *
 *  @note
 *   commandBuffer                                          \n
 *   - [2..3] => 16-bit register number [MSB ignored]       \n
 *                                                          \n
 *   commandBuffer                                          \n
 *   - [1..4] => 32-bit register value  [some MSBs ignored]
 *
 *  @return == BDM_RC_OK => success
 *  @return != BDM_RC_OK => error
 */
USBDM_ErrorCode f_CMD_READ_REG(void) {
   USBDM_ErrorCode rc = BDM_RC_ILLEGAL_PARAMS;

   commandBuffer[1] = 0;
   commandBuffer[2] = 0;

   switch (commandBuffer[3]) {
      case HCS08_RegPC : // or RS08_RegCCR_PC :
         rc = BDM08_CMD_READ_PC(commandBuffer+3);
         break;
      case HCS08_RegHX  :
         if (cable_status.target_type == T_HCS08)
            rc = BDM08_CMD_READ_HX(commandBuffer+3);
         break;
      case HCS08_RegSP : // or RS08_RegSPC
         rc = BDM08_CMD_READ_SP(commandBuffer+3);
         break;
      case HCS08_RegA  : // or RS08_RegA
         commandBuffer[3] = 0;
         rc = BDM08_CMD_READ_A(commandBuffer+4);
         break;
      case HCS08_RegCCR :
         commandBuffer[3] = 0;
         if (cable_status.target_type == T_HCS08)
            rc = BDM08_CMD_READ_CCR(commandBuffer+4);
         break;
   }
   returnSize = 5;
   return rc;
}

/**
 *  HCS08/RS08 Write to Breakpoint reg
 *
 *  @note
 *   commandBuffer                                    \n
 *   - [2..3] => 16-bit register number [ignored]     \n
 *   - [4..7] => 32-bit register value  [MSBs ignored]
 *
 *  @return == BDM_RC_OK => success
 *  @return != BDM_RC_OK => error
 */
USBDM_ErrorCode f_CMD_WRITE_BKPT(void) {
   BDM08_CMD_WRITE_BKPT(pack16BE(commandBuffer+6));
   return BDM_RC_OK;
}

/**
 *  HCS08/RS08 Read from Breakpoint reg
 *
 *  @note
 *   commandBuffer                                          \n
 *   - [2..3] => 16-bit register number [ignored]           \n
 *   - [1..4] => 32-bit register value  [MSBs zeroed]       \n
 *                                                          \n
 *   commandBuffer                                          \n
 *   - [1..4] => 32-bit register value  [some MSBs ignored]
 *
 *  @return == BDM_RC_OK => success
 *  @return != BDM_RC_OK => error
 */
USBDM_ErrorCode f_CMD_READ_BKPT(void) {
   commandBuffer[1] = 0;
   commandBuffer[2] = 0;
   BDM08_CMD_READ_BKPT(commandBuffer+3);
   returnSize = 5;
   return BDM_RC_OK;
}

}; // namespace Hcs08

namespace S12z {

using namespace Bdm;

/**
 * Write an arbitrary command using BDM protocol
 *
 * @return == BDM_RC_OK => success
 * @return != BDM_RC_OK => error
 */
USBDM_ErrorCode f_CMD_CUSTOM_COMMAND(void) {
   cmd_0_0_NOACK(_BDMZ12_ERASE_FLASH);
   acknowledgeOrWait64();
   cmd_0_0_NOACK(_BDMZ12_ERASE_FLASH);
   acknowledgeOrWait64();
   return BDM_RC_OK;
}

}; // End namespace S12z

#if (HW_CAPABILITY & CAP_FLASH)

namespace Rs08 {

/**
 *  Control target VPP level
 *
 *  @note
 *   commandBuffer                                  \n
 *   - [2] =>  (FlashState_t) control value for VPP \n
 *
 *  @return == BDM_RC_OK => success
 *  @return != BDM_RC_OK => error
 */
USBDM_ErrorCode f_CMD_SET_VPP(void) {
   return bdmSetVpp(commandBuffer[2]);
}

}; // End namespace Rs08

#endif // (HW_CAPABILITY & CAP_FLASH)
