podonoghue/usbdm-kinetis/(commit log)

2016-10-27 V2.0.0 Cleanup
    [USBDM_Kinetis.SchDoc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]
2016-10-27 V2.0.0 Release build of hardware
    [USBDM_Kinetis.PcbDoc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]
2016-10-31 V2.0.0 Added TVdd LED
    [USBDM_Kinetis.PcbDoc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]
2016-10-31 V2.0.0 Cosmetic changes
    [USBDM_Kinetis.PcbDoc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]
2016-11-06 V2.0.0 PCB cleanup
    [USBDM_Kinetis.PcbDoc, USBDM_Kinetis.SchDoc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]
2016-11-10 V2.0.0 PCB cleanup, added paste layer output
    [USBDM_Kinetis.GBL, USBDM_Kinetis.GBO, USBDM_Kinetis.GBP, USBDM_Kinetis.GBS, USBDM_Kinetis.GKO, USBDM_Kinetis.GTL, USBDM_Kinetis.GTO, USBDM_Kinetis.GTP]
2016-11-21 V2.0.1 Added protection ZVS to interface
    [USBDM_Kinetis.GBL, USBDM_Kinetis.GBO, USBDM_Kinetis.GBS, USBDM_Kinetis.GKO, USBDM_Kinetis.GTL, USBDM_Kinetis.GTO, USBDM_Kinetis.GTP, USBDM_Kinetis.GTS]
2016-11-21 V2.0.0 Regenerated PDF
    [USBDM_Kinetis.PcbDoc, USBDM_Kinetis.PrjPcb]
2016-11-27 V2.0.0 Swapped SWD_DIR pin mapping so even FTM channel available
2016-11-27 V2.0.0 Refactor
    [USBDM_Kinetis.PrjPcb]
2016-12-03 V2.0.0 Work related to BDM mode (WIP)
    [USBDM_Kinetis.PcbDoc]
2016-12-05 V2.0.0 Fixed Endian faults
    [cmdProcessingCFV1.cpp, cmdProcessingHCS.cpp]
2016-12-05 V3.0 PCB changes
    [USBDM_Kinetis.PcbDoc, USBDM_Kinetis.SchDoc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]
2016-12-07 Fixes for getPinState() functions
    [bdm.cpp, main.cpp, swd.cpp]
2016-12-07 Added PCB Image
    [USBDM_Kinetis.PcbDoc, USBDM_Kinetis.PrjPcb]
2016-12-08 Resized PCB Image
2016-12-08 Minor changes
    [USBDM_Kinetis.SchDoc]
2016-12-20 Changes to some component values to reduce number of different devices
    [USBDM_Kinetis.PcbDoc, USBDM_Kinetis.SchDoc]
2016-12-20 Updated footprints
    [USBDM_Kinetis.GBL, USBDM_Kinetis.GBO, USBDM_Kinetis.GBS, USBDM_Kinetis.GKO, USBDM_Kinetis.GTL, USBDM_Kinetis.GTO, USBDM_Kinetis.GTP, USBDM_Kinetis.GTS]
2016-12-20 Regenerated Gerbers etc (and released to OSH Park)
    [USBDM_Kinetis.GBL, USBDM_Kinetis.GBO, USBDM_Kinetis.GBS, USBDM_Kinetis.GKO, USBDM_Kinetis.GTL, USBDM_Kinetis.GTO, USBDM_Kinetis.GTP, USBDM_Kinetis.GTS]
2016-12-21 Added target Vdd control and related fixes
    [USBDM_MK20D5.h, bdm.cpp, cmdProcessing.cpp, cmdProcessingHCS.cpp, configure.h, main.cpp, mcg.cpp]
2016-12-22 Added comparator to Vbdm
    [USBDM_Kinetis.GBL, USBDM_Kinetis.GBO, USBDM_Kinetis.GBS, USBDM_Kinetis.GKO, USBDM_Kinetis.GTL, USBDM_Kinetis.GTO, USBDM_Kinetis.GTP, USBDM_Kinetis.GTS]
2016-12-27 Respaced some components
    [USBDM_Kinetis.PcbDoc, USBDM_Kinetis.SchDoc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]
2016-12-30 Updated board image
    [USBDM_Kinetis.PcbDoc]
2016-12-30 V3.0 Minor Changes
    [USBDM_Kinetis.PcbDoc, USBDM_Kinetis.SchDoc]
2017-01-06 V3.0 Folder Rename
    [USBDM_Kinetis.GBL, USBDM_Kinetis.GBO, USBDM_Kinetis.GBP, USBDM_Kinetis.GBS, USBDM_Kinetis.GKO, USBDM_Kinetis.GTL, USBDM_Kinetis.GTO, USBDM_Kinetis.GTP]
2017-01-07 V3.0 Added Cin on switch
    [USBDM_Kinetis.GBL, USBDM_Kinetis.GBO, USBDM_Kinetis.GBS, USBDM_Kinetis.GKO, USBDM_Kinetis.GTL, USBDM_Kinetis.GTO, USBDM_Kinetis.GTP, USBDM_Kinetis.GTS]
2017-01-07 V3.0 Updated LED foot prints
2017-01-22 V3.0 Cleanup
    [USBDM_Kinetis.GBL, USBDM_Kinetis.GBO, USBDM_Kinetis.GBP, USBDM_Kinetis.GBS, USBDM_Kinetis.GKO, USBDM_Kinetis.GTL, USBDM_Kinetis.GTO, USBDM_Kinetis.GTP]
2017-01-22 V3.0 Cleanup & regeneration of output files
    [USBDM_Kinetis.GBL, USBDM_Kinetis.GBO, USBDM_Kinetis.GBP, USBDM_Kinetis.GBS, USBDM_Kinetis.GKO, USBDM_Kinetis.GTL, USBDM_Kinetis.GTO, USBDM_Kinetis.GTP]
2017-01-26 V3.1 Settled on MK22F version to continue
    [USBDM_Kinetis.GBL, USBDM_Kinetis.GBO, USBDM_Kinetis.GBP, USBDM_Kinetis.GBS, USBDM_Kinetis.GKO, USBDM_Kinetis.GTL, USBDM_Kinetis.GTO, USBDM_Kinetis.GTP]
2017-01-26 V5.0 Firmware - Moved Debug Tx/Rx signals (changed UART)
2017-02-05 V5.0 Firmware - Work on Target Vdd monitoring (Cmp/Pin Irqs)
2017-02-05 V5.0 Firmware - Work on Reset monitoring (Pin Irqs)
    [resetInterface.h]
2017-02-05 V3.1 Hardware - Added pull-down to Vdd_En
    [USBDM_Kinetis.GBL, USBDM_Kinetis.GBO, USBDM_Kinetis.GBS, USBDM_Kinetis.GKO, USBDM_Kinetis.GTL, USBDM_Kinetis.GTO, USBDM_Kinetis.GTP, USBDM_Kinetis.GTS]
2017-02-05 V3.1 Hardware - Added spreadsheet to calculate ID resistors
    [Id.xlsx]
2017-02-06 V3.2 Hardware - Added pull-down on Vdd_En
    [USBDM_Kinetis.PcbDoc, USBDM_Kinetis.SchDoc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]
2017-02-07 V3.2 Hardware - Release
    [USBDM_Kinetis.GBL, USBDM_Kinetis.GBO, USBDM_Kinetis.GBS, USBDM_Kinetis.GKO, USBDM_Kinetis.GTL, USBDM_Kinetis.GTO, USBDM_Kinetis.GTP, USBDM_Kinetis.GTS]
2017-02-28 V5.0 Firmware - Corrected error in reset monitoring
    [targetVddInterface.h]
2017-02-28 V5.0 Firmware - Increase comparator filtering
2017-03-02 V3.2 Hardware - Updated E14 Part #s, modified PDF assembly
    [USBDM_Kinetis.SchDoc]
2017-03-31 V3.2 Hardware - Minor
    [USBDM_Kinetis.PcbDoc]
2017-04-19 V3.3 Hardware - Switch change
    [USBDM_Kinetis.GBL, USBDM_Kinetis.GBO, USBDM_Kinetis.GBS, USBDM_Kinetis.GKO, USBDM_Kinetis.GTL, USBDM_Kinetis.GTO, USBDM_Kinetis.GTP, USBDM_Kinetis.GTS]
2018-01-07 V5.0 Firmware - Fixes for PinSet and monitoring
    [bdm.cpp, bdm.h, bdmMacros.h, cmdProcessing.cpp, cmdProcessingCFV1.cpp, cmdProcessingHCS.cpp, cmdProcessingHCS.h, configure.h]
2018-01-08 V5.0 Firmware - Work on target Vdd and Reset monitoring
    [main.cpp, targetVddInterface.h]
2019-02-08 V5.1.0 Firmware - Added derived project files. Fixed alignment bug in optimized build. Improved resume handling.
    [cmdProcessing.cpp, configure.h, main.cpp, mcg.cpp]
2019-02-15 V5.1.0 Firmware - fixed incorrect IRQ level for ISB/UART - need to be equal
2019-02-15 V5.1.0 Firmware - fixed handling of internal/external Vdd state
    [cmdProcessing.cpp, targetVddInterface.h]
2019-10-18 V5.1.0 Significant changes to be more compatible with JLCPCB manufacture - incomplete SMT due to unavailable components.
    [Bill of Materials-USBDM_Kinetis_MK22F.xls, Pick Place for USBDM_Kinetis.csv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]
2021-01-19 V5.1.0 Hardware - Updated PDF, Exported PCB in V5 format
    [USBDM_Kinetis-CS.PcbDoc, USBDM_Kinetis.PcbDoc, USBDM_Kinetis.SchDoc, USBDM_Kinetis_MK22F.PrjPcb]
2021-05-16 V5.2.0 Firmware - Fixes to USB (stability) Fixes to HCS08 memory writes - was badly broken
    [bdm.cpp, bdmMacros.h, cmdProcessing.cpp, cmdProcessingHCS.cpp, main.cpp, mcg.cpp]
2021-05-20 V5.2.0 Firmware - Improvements to SWD SPI code
2021-05-27 V5.2.0 Firmware - Fixed CDC bug with incorrect baud rate
    [SWD Formats.ods]
2022-01-15 V5.2.0 Firmware - Some refactoring and cleanup. Adopted use of automatically created pin classes
2022-01-15 V5.2.0 Firmware - Fixed spurious empty command received when device is re-enumerated
    [cmdProcessing.cpp]
2022-01-15 V5.2.0 Hardware - deleted generated files
    [Bill of Materials-USBDM_Kinetis_MK22F.xls, Pick Place for USBDM_Kinetis.csv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]
2022-01-15 V5.2.0 Hardware - deleted generated files. Minor updates
    [USBDM_Kinetis.PcbDoc]
2022-02-17 V5.2.0 Hardware - Minor updates
    [USBDM_Kinetis.PcbDoc, USBDM_Kinetis.SchDoc, USBDM_Kinetis_MK22F.PrjPcb]
2022-02-20 V5.2.0 Hardware - Updated board image
2022-03-20 Fixed various errors in HCS code (failed to release FTM control)
    [bdm.cpp, bdm.h, cmdProcessing.cpp, cmdProcessingHCS.cpp, interfaceCommon.cpp, targetVddInterface.h]
2022-06-16 V5.6 - Changing between interface types now done correctly.
    [interfaceCommon.cpp]
2023-04-05 V5.6 - Updated stationery - fix for incorrect data toggle on Linux after suspend
    [bdm.cpp, configure.h, mcg.cpp]
2024-08-22 V5.8 - Fixed reporting of BDM interface frequency for HC devices
    [bdm.cpp]
